HOLOGRAPHICpizza/logic-clock/schematic/logic-clock-layout.jpg

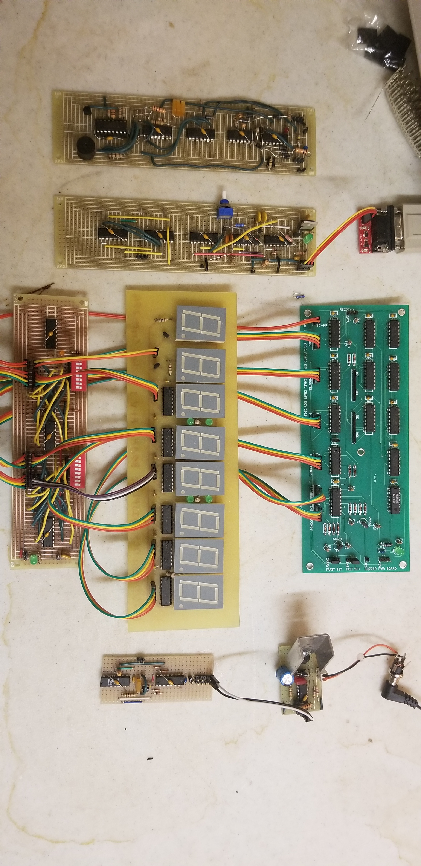
schematic/logic-clock-layout.jpg
