HOLOGRAPHICpizza/logic-clock/README.txt

Digital "synchronous" clock in 4000 series logic w/ incremental volume alarm and optional time set via RS-232.

By Michael Craft.

Released under the 2-Clause BSD License.
