HOLOGRAPHICpizza/logic-clock/schematic/logic-clock.pdf

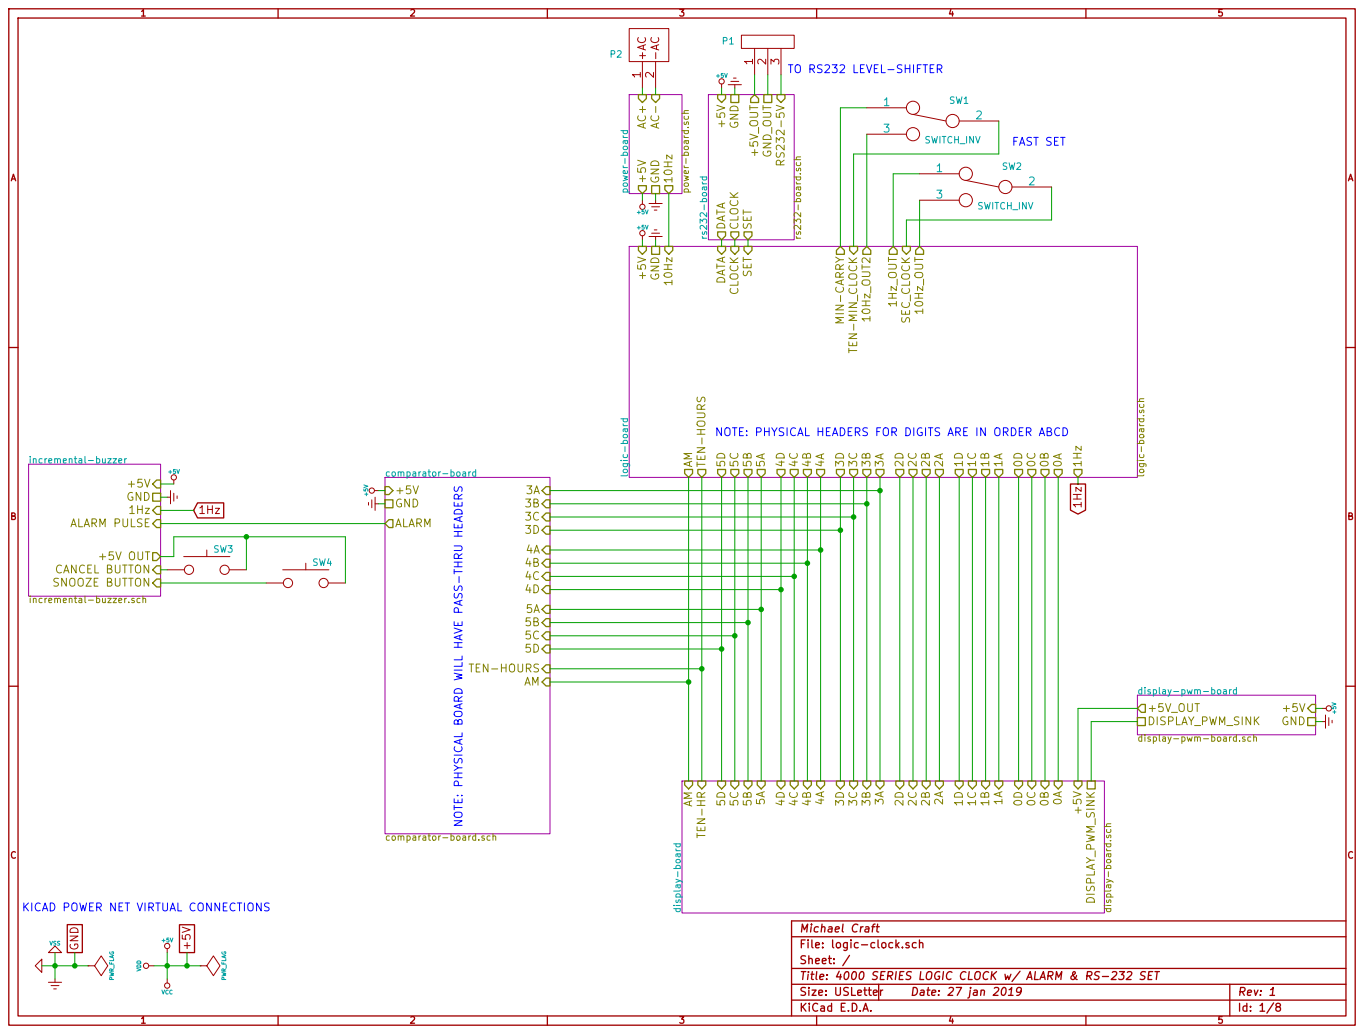
[picture p2: page 1]

comparator-board
comparator-board.sch +5V GND

incremental-buzzer.sch +5V GND

DISPLAY_PWM_SINK
display-pwm-board.sch

KICAD POWER NET VIRTUAL CONNECTIONS

Michael Craft
File: logic-clock.sch
Sheet: /
Title: 4000 SERIES LOGIC CLOCK w/ ALARM & RS-232 SET
KiCad E.D.A.

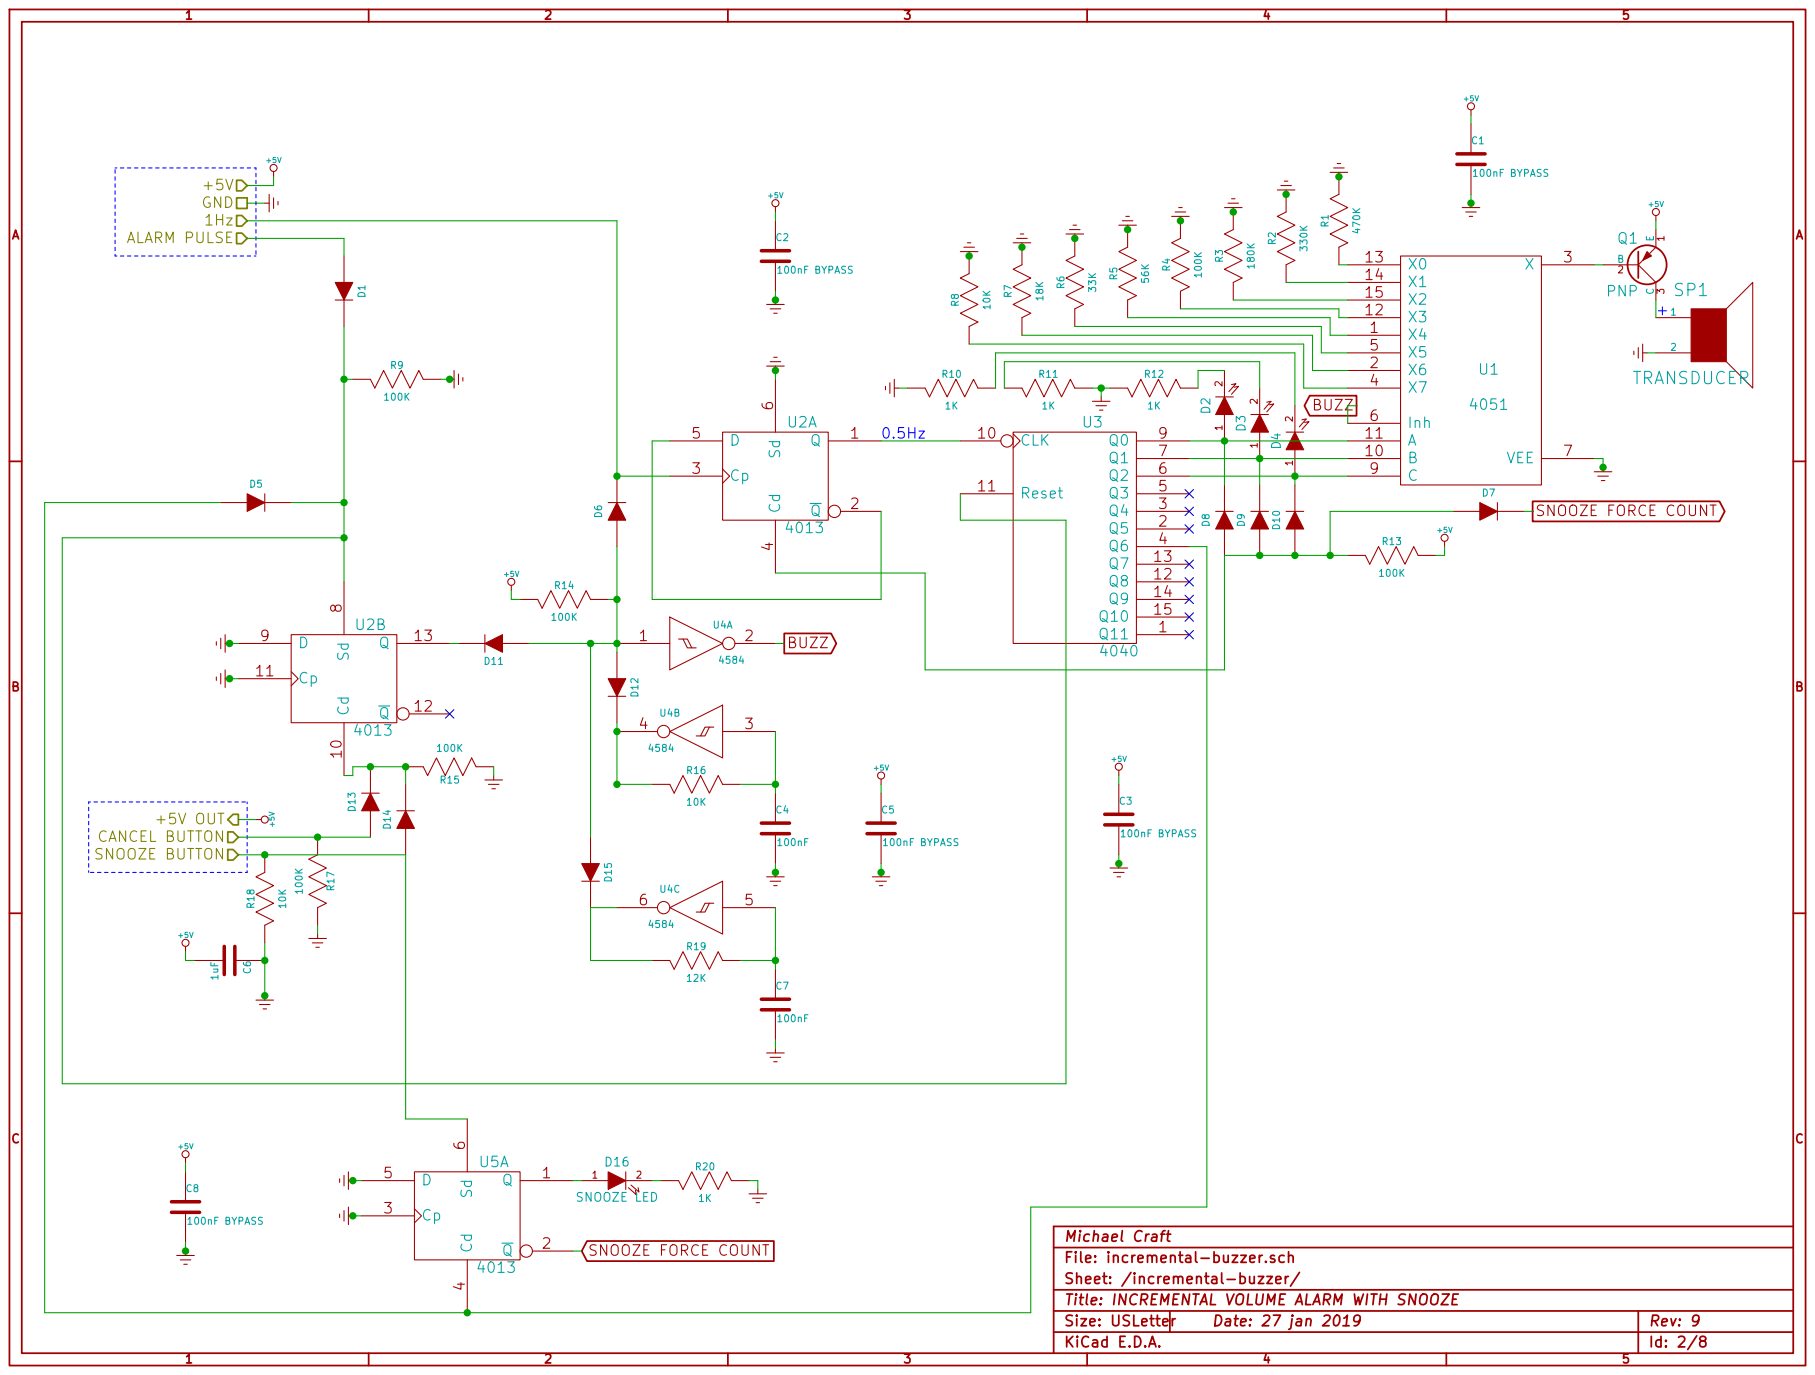
[picture p3: page 2]

Michael Craft
File: incremental-buzzer.sch Sheet: /incremental-buzzer/

Title: INCREMENTAL VOLUME ALARM WITH SNOOZE

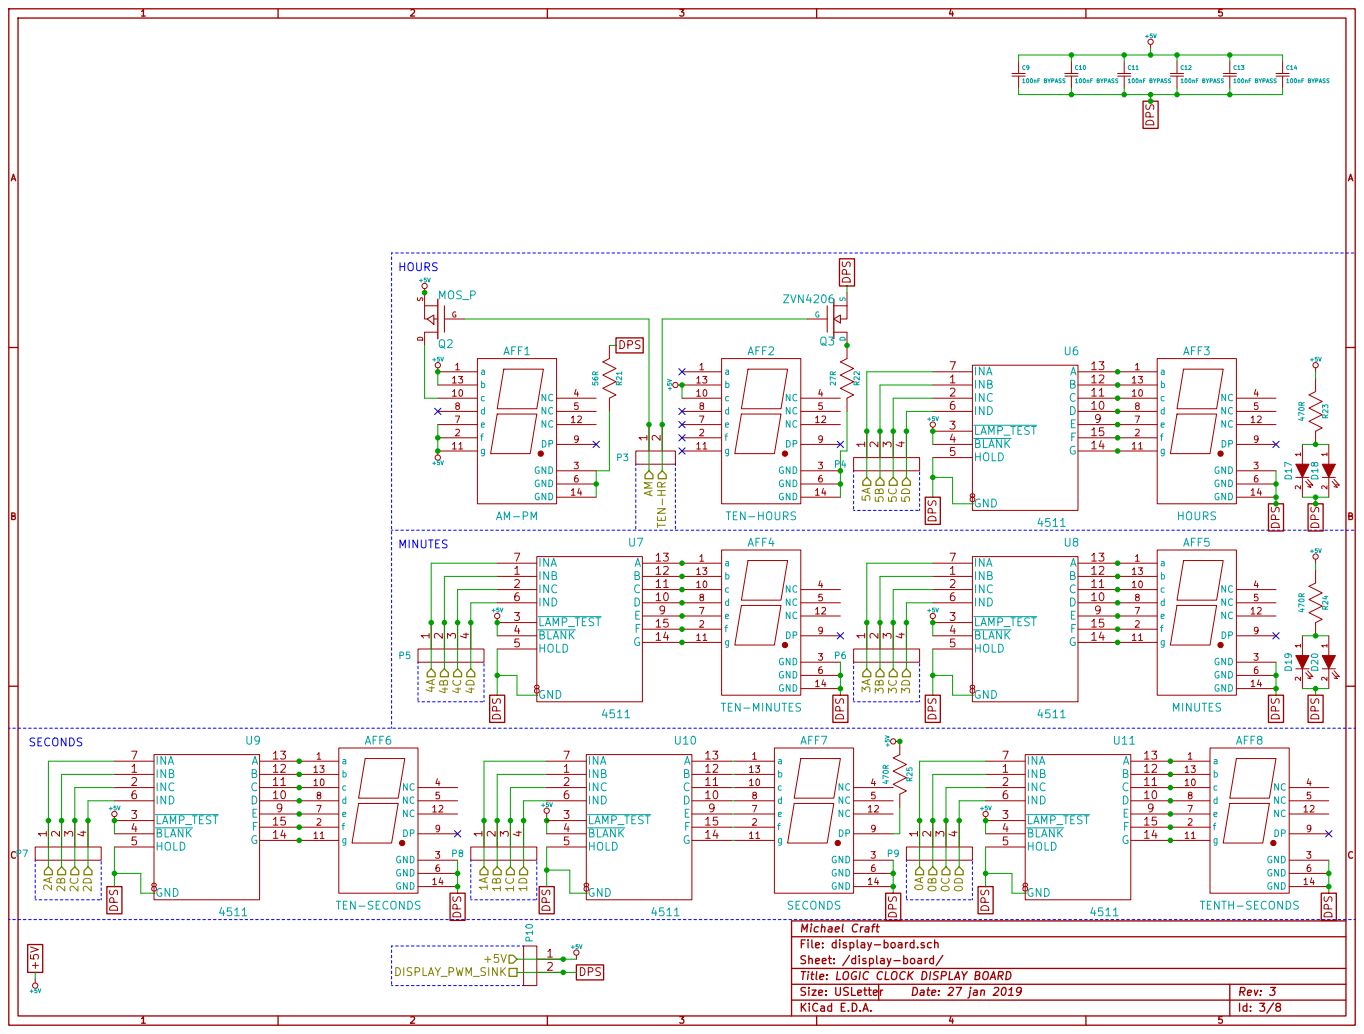
[picture p4: page 3]

Michael Craft
File: display-board.sch
Sheet: /display-board/
Title: LOGIC CLOCK DISPLAY BOARD

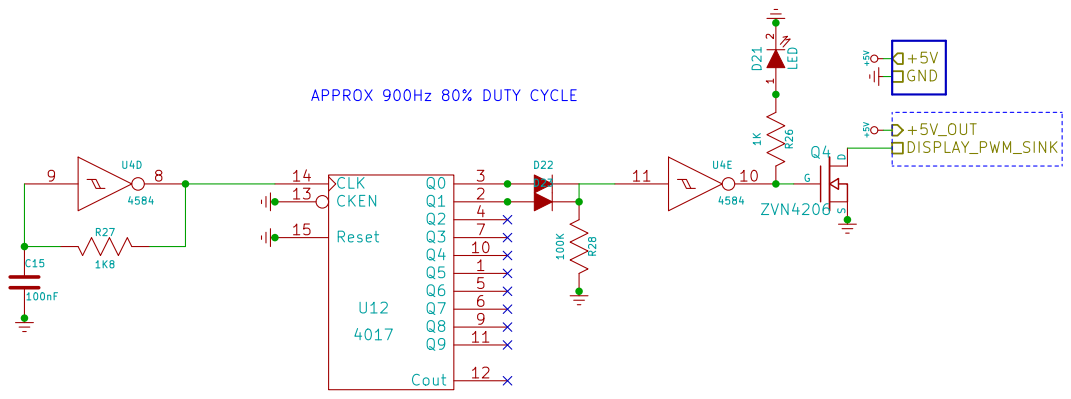
[picture p5: page 4]

Michael Craft
File: display-pwm-board.sch
Sheet: /display-pwm-board/
Title: LOGIC CLOCK DISPLAY PWM SIGNAL GENERATOR

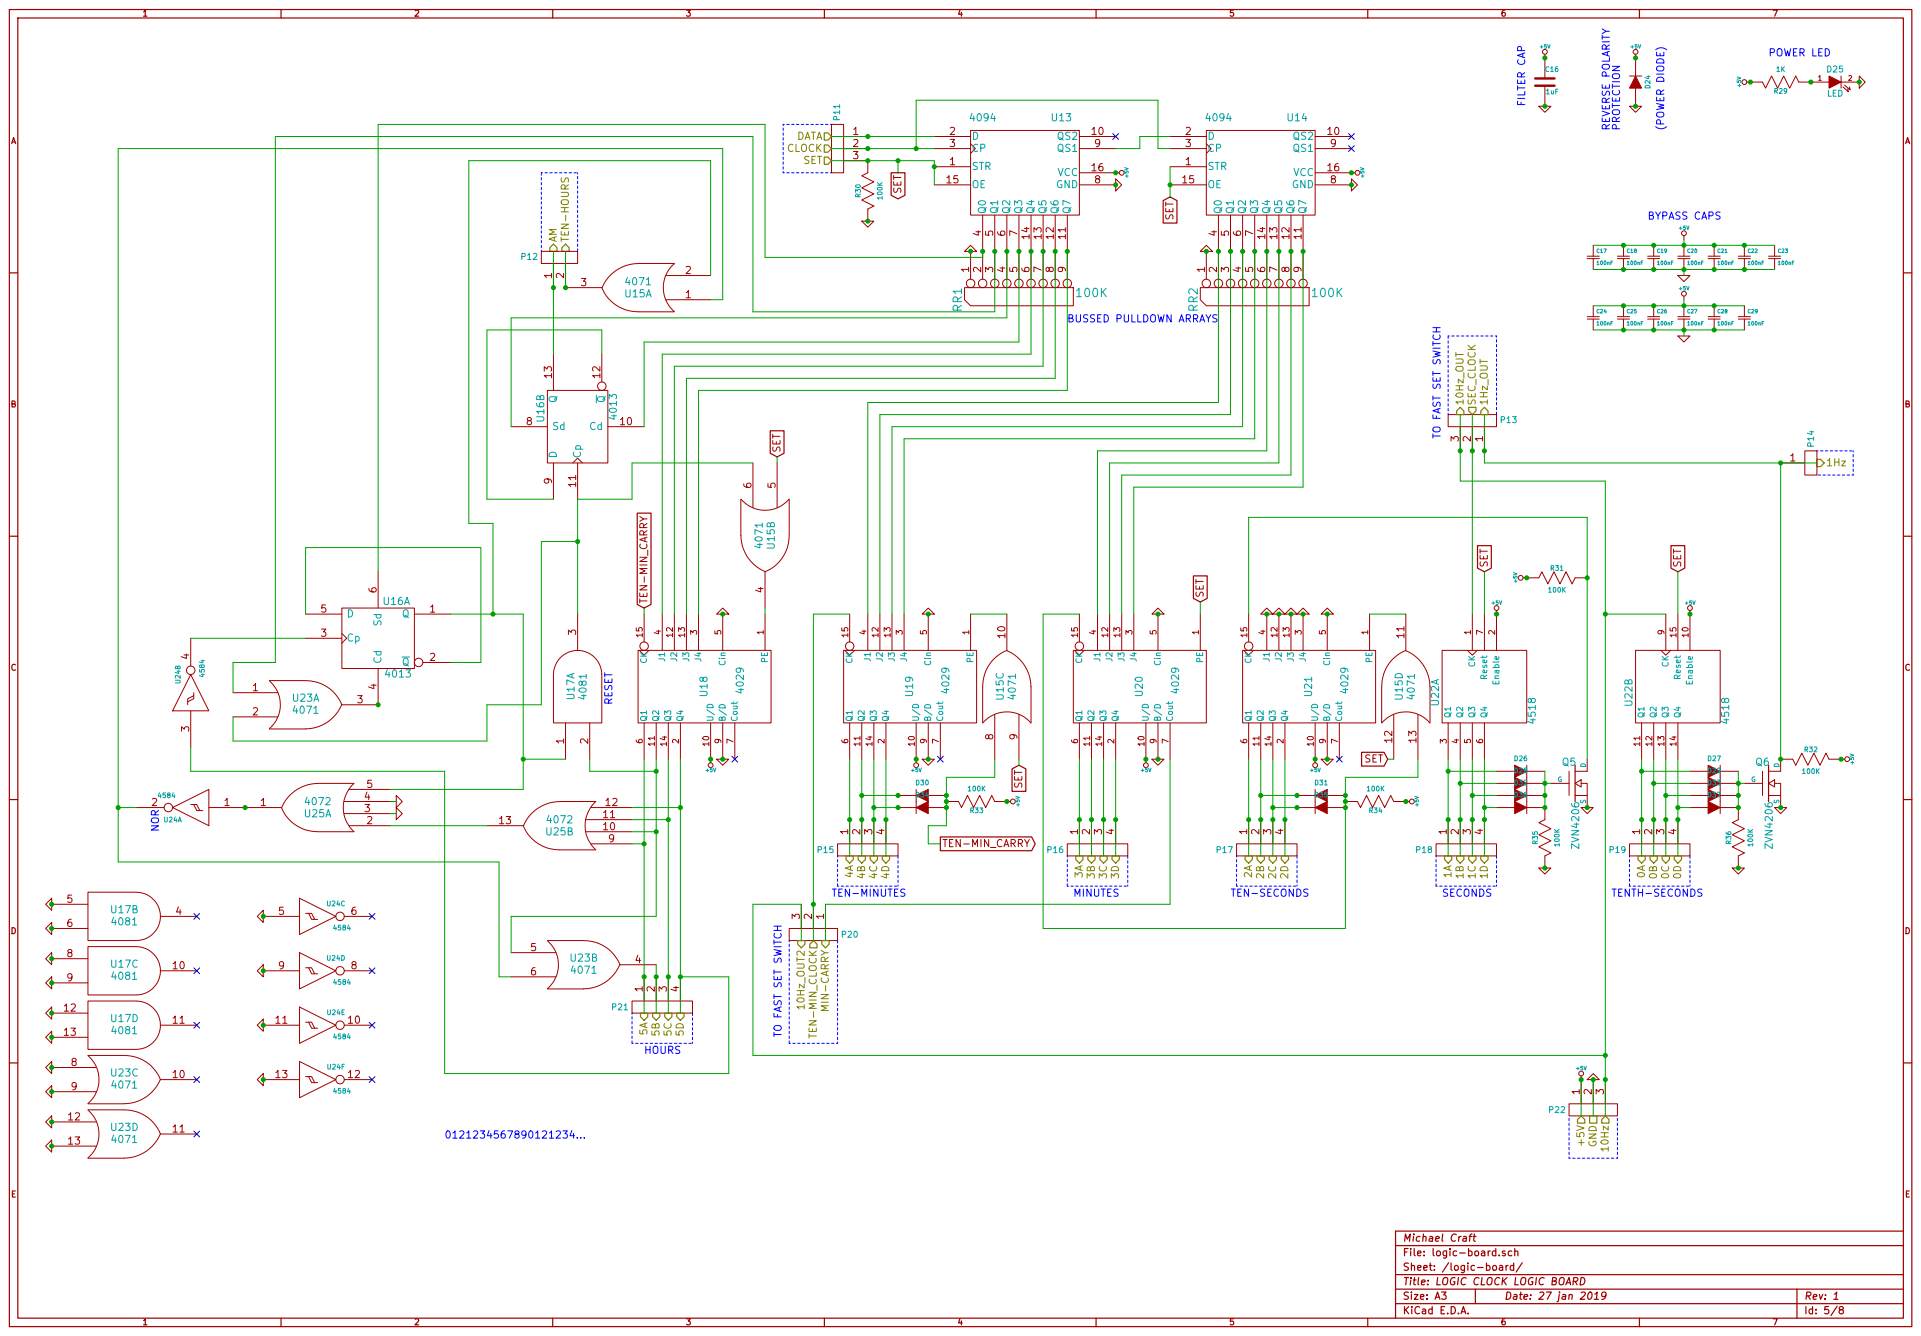
[picture p6: page 5]

9 Cd 10 Cp 11 Q 12 Q 13 U16B 4013 AMTEN-HOURS

P13 10Hz_OUT SEC_CLOCK 1Hz_OUT TO FAST SET SWITCH

File: logic-board.sch
Sheet: /logic-board/
Title: LOGIC CLOCK LOGIC BOARD

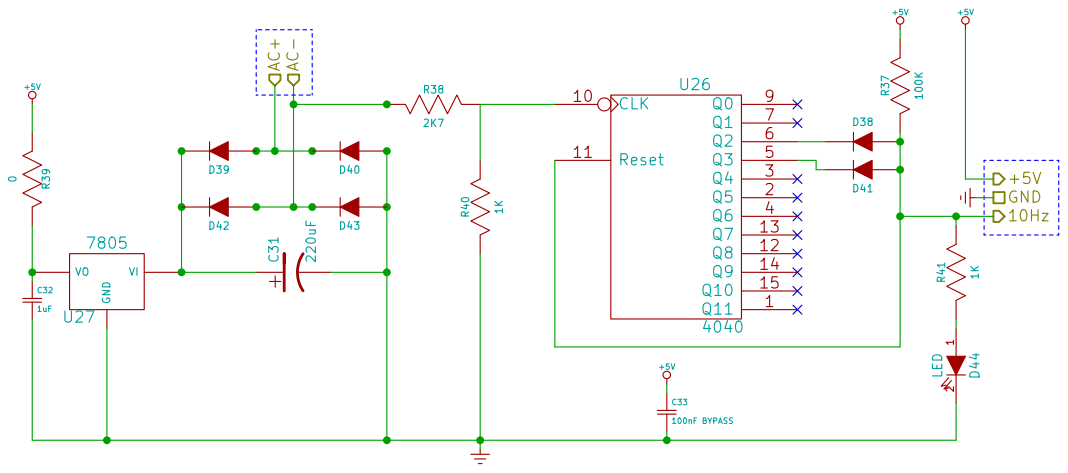
[picture p7: page 6]

File: power-board.sch

Title: 60Hz LOW VOLTAGE AC TO DC SUPPLY W/ 10Hz OUT

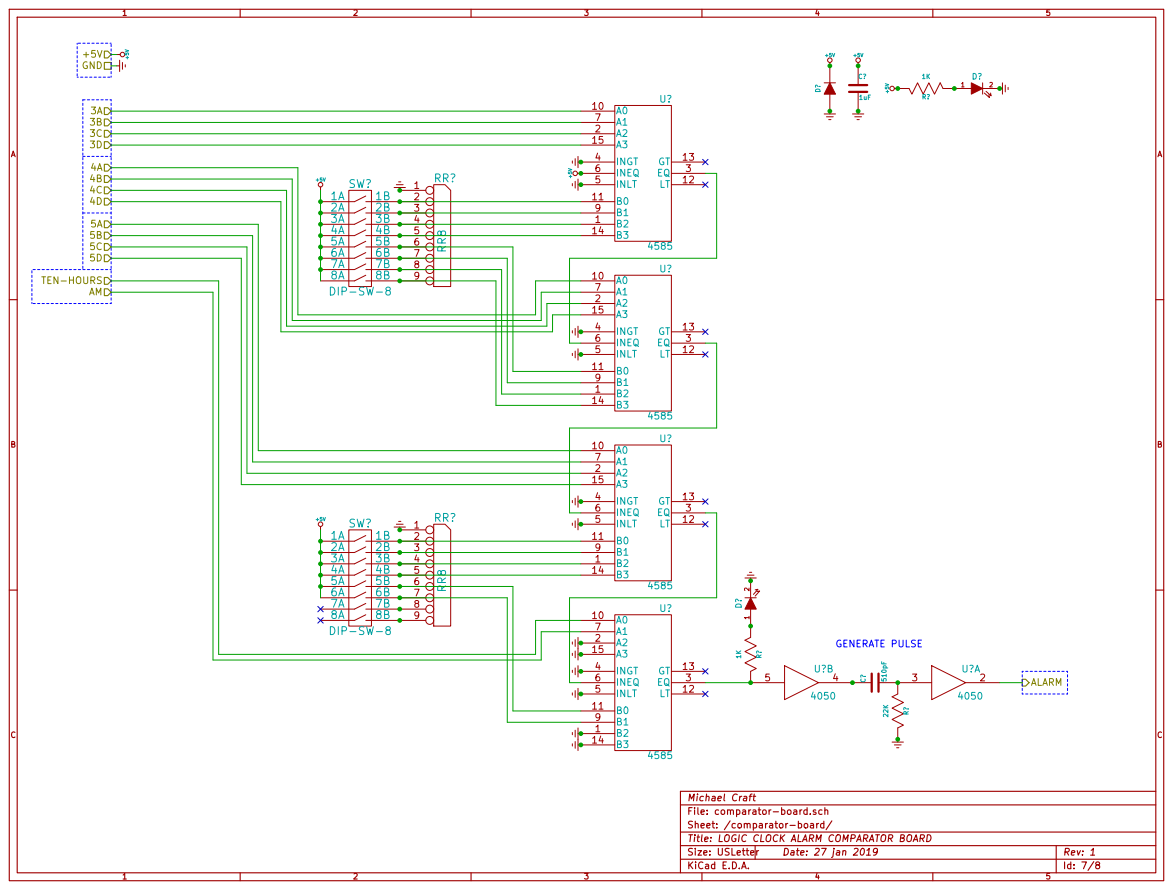
[picture p8: page 7]

Michael Craft
File: comparator-board.sch
Sheet: /comparator-board/
Title: LOGIC CLOCK ALARM COMPARATOR BOARD

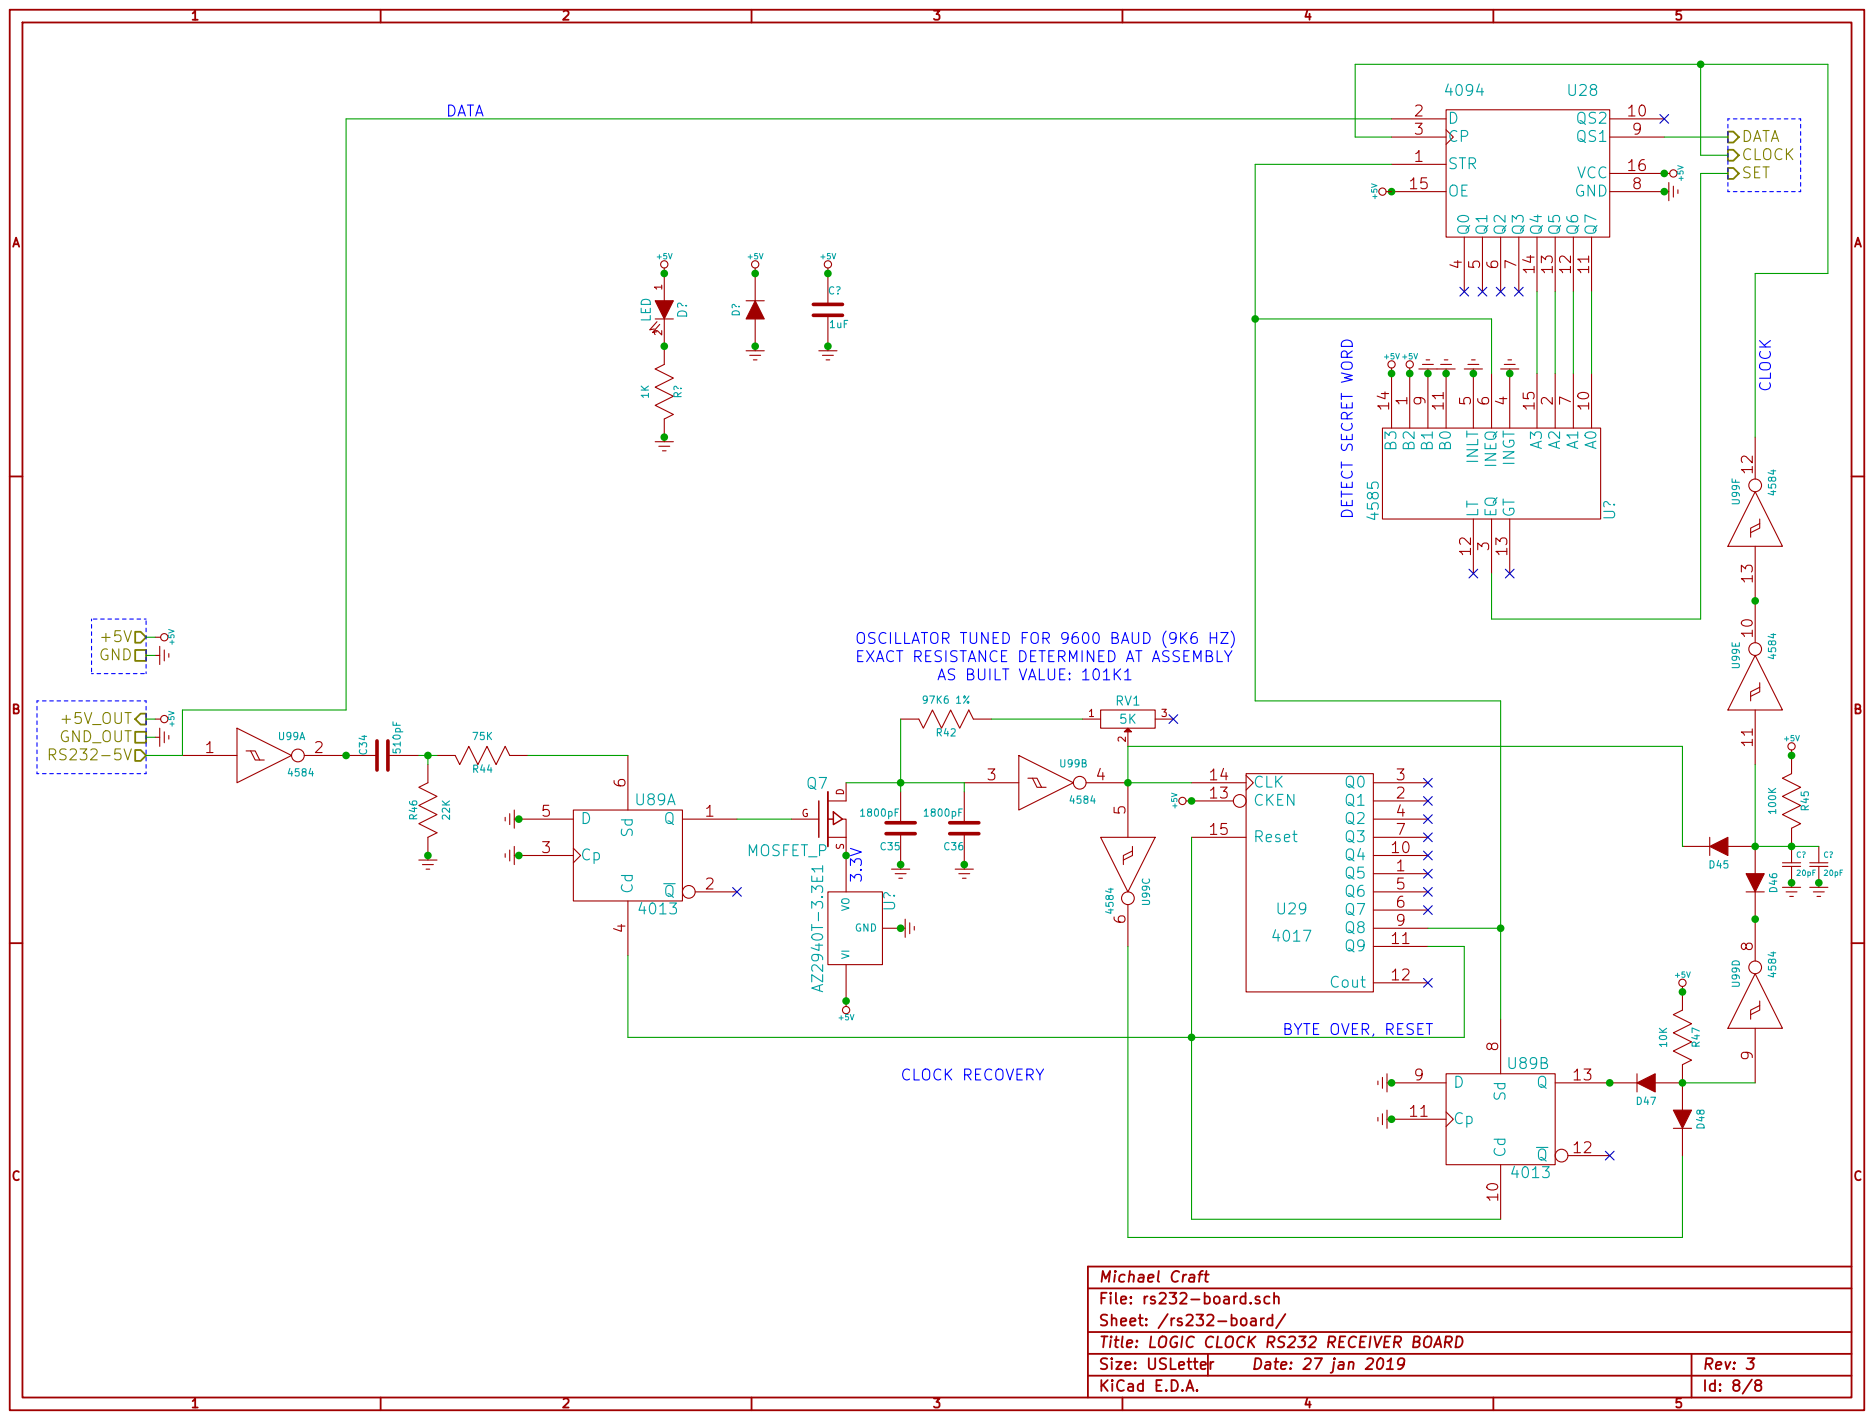
[picture p9: page 8]

1uF EXACT RESISTANCE DETERMINED AT ASSEMBLY

OSCILLATOR TUNED FOR 9600 BAUD (9K6 HZ)

Michael Craft
File: rs232-board.sch Sheet: /rs232-board/

Title: LOGIC CLOCK RS232 RECEIVER BOARD
