HOLOGRAPHICpizza/logic-clock/schematic/display-board_Cu.pdf

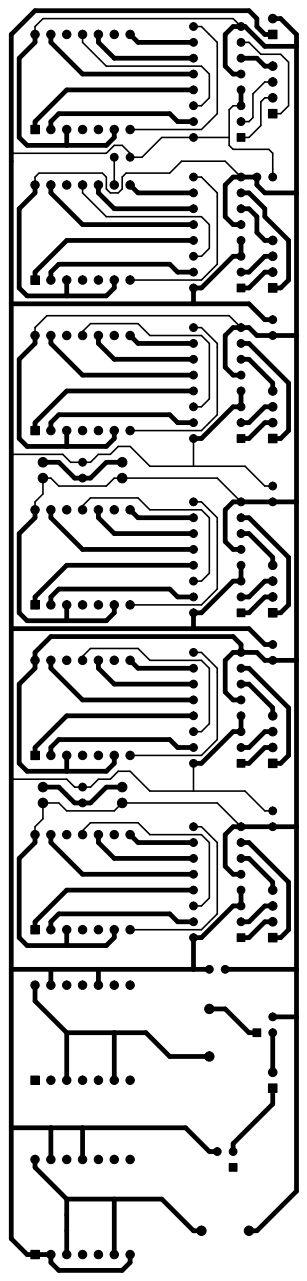
[picture p10: page 1]
