HOLOGRAPHICpizza/logic-clock/(list of files, drawings)

Other design files:
schematic/logic-clock.dsn
