HOLOGRAPHICpizza/logic-clock/schematic/logic-clock.kicad_pcb

## KiCad design schematic/logic-clock.kicad_pcb (2018-11-24)

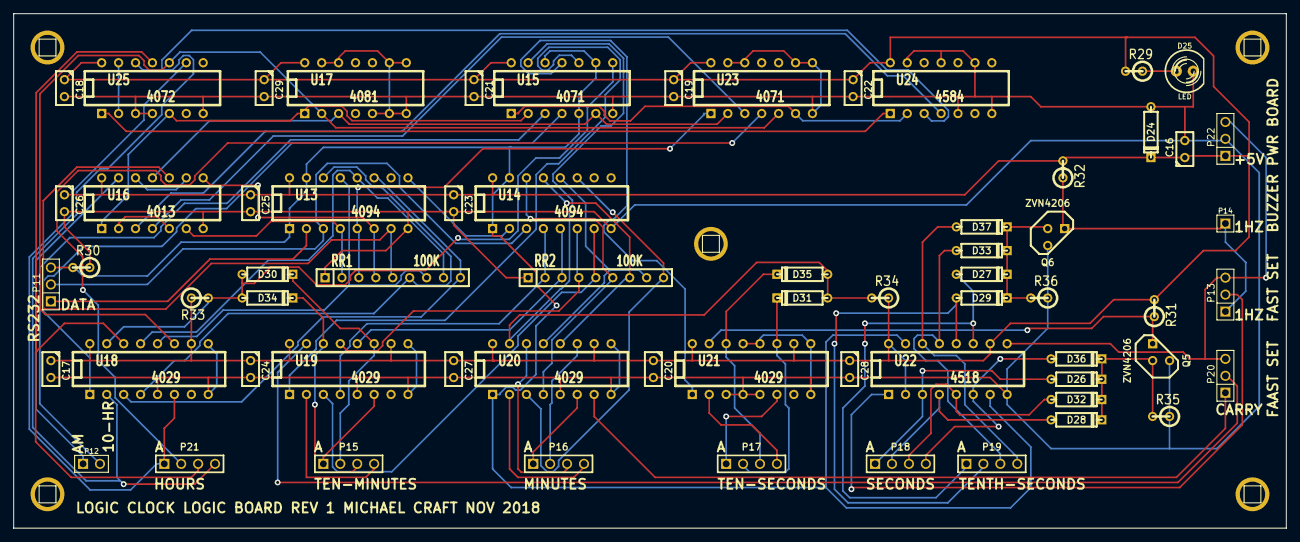
[picture p11: board logic-clock.kicad_pcb from above]

Board: 2 copper layers, 191.0 x 77.2 mm, 65 parts (0 on the bottom side), 72 nets.

Parts:
C16: 1uF; C1
C17, C18, C19, C20, C21, C22, C23, C24, C25, C26, C27, C28, C29: 100nF; C1
D24, D26, D27, D28, D29, D30, D31, D32, D33, D34, D35, D36, D37: DIODE; D3
D25: LED; LED-5MM
P11, P13, P20, P22: 3-PIN_HEADER; PIN_ARRAY_3X1
P12: 2-PIN_HEADER; PIN_ARRAY_2X1
P14: 1-PIN_HEADER; PIN_ARRAY_1
P15, P16, P17, P18, P19, P21: 4-PIN_HEADER; PIN_ARRAY_4x1
Q5, Q6: ZVN4206; TO92DGS
R29: 1K; R1
R30, R31, R32, R33, R34, R35, R36: 100K; R1
RR1, RR2: 100K; SIL-9
U13, U14: 4094; DIP-16__300
U15, U23: 4071; DIP-14__300
U16: 4013; DIP-14__300
U17: 4081; DIP-14__300
U18, U19, U20, U21: 4029; DIP-16__300
U22: 4518; DIP-16__300
U24: 4584; DIP-14__300
U25: 4072; DIP-14__300

Connections:
1Hz: P13.1, P14.1, Q6.D, R32.1
+5V: C16.1, C17.1, C18.1, C19.1, C20.1, C21.1, C22.1, C23.1, C24.1, C25.1, C26.1, C27.1, C28.1, C29.1, D24.2, P22.1, R29.2, R31.2, R32.2, R33.1, R34.1, U13.16, U14.16, U15.14, U16.14, U17.14, U18.10, U18.16, U19.10, U19.16, U20.10, U20.16, U21.10, U21.16, U22.2, U22.10, U22.16, U23.14, U24.14, U25.14
/comparator-board/3A: P16.1, U20.6
/comparator-board/3B: P16.2, U20.11
/comparator-board/3C: P16.3, U20.14
/comparator-board/3D: P16.4, U20.2
/comparator-board/4A: P15.1, U19.6
/comparator-board/4B: D30.2, P15.2, U19.11
/comparator-board/4C: D34.2, P15.3, U19.14
/comparator-board/4D: P15.4, U19.2
/comparator-board/5A: P21.1, U18.6, U25.9
/comparator-board/5B: P21.2, U23.4
/comparator-board/5C: P21.3, U18.14, U25.11
/comparator-board/5D: P21.4, U18.2, U24.3, U25.12
/comparator-board/AM: P12.1, U16.13
/comparator-board/TEN-HOURS: P12.2, U15.3
/display-board/0A: D27.1, P19.1, U22.11
/display-board/0B: D29.1, P19.2, U22.12
/display-board/0C: D33.1, P19.3, U22.13
/display-board/0D: D37.1, P19.4, U22.14
/display-board/1A: D26.1, P18.1, U22.3
/display-board/1B: D28.1, P18.2, U22.4
/display-board/1C: D32.1, P18.3, U22.5
/display-board/1D: D36.1, P18.4, U22.6
/display-board/2A: P17.1, U21.6
/display-board/2B: D31.2, P17.2, U21.11
/display-board/2C: D35.2, P17.3, U21.14
/display-board/2D: P17.4, U21.2
/logic-board/10Hz: P13.3, P20.3, P22.3, U22.9
/logic-board/CLOCK: P11.2, U13.3, U14.3
/logic-board/DATA: P11.1, U13.2
/logic-board/MIN-CARRY: P20.1, U20.7
/logic-board/SEC_CLOCK: P13.2, U22.1
/logic-board/TEN-MIN_CLOCK: P20.2, U19.15
GND: C16.2, C17.2, C18.2, C19.2, C20.2, C21.2, C22.2, C23.2, C24.2, C25.2, C26.2, C27.2, C28.2, C29.2, D24.1, D25.2, P22.2, Q5.S, Q6.S, R30.1, R35.1, R36.1, RR1.1, RR2.1, U13.8, U14.8, U15.7, U16.7, U17.5, U17.6, U17.7, U17.8, U17.9, U17.12, U17.13, U18.5, U18.8, U18.9, U19.5, U19.8, U19.9, U20.5, U20.8, U20.9, U21.3, U21.4, U21.5, U21.8, U21.9, U21.12, U21.13, U22.8, U23.7, U23.8, U23.9, U23.12, U23.13, U24.5, U24.7, U24.9, U24.11, U24.13, U25.3, U25.4, U25.7
unnamed: RR1.6, U13.14, U18.4
unnamed: RR1.5, U13.7, U16.10
unnamed: RR1.4, U13.6, U16.8
unnamed: RR2.9, U14.11, U20.3
unnamed: RR2.8, U14.12, U20.13
unnamed: RR2.7, U14.13, U20.12
unnamed: RR2.6, U14.14, U20.4
unnamed: RR2.5, U14.7, U19.3
unnamed: RR2.4, U14.6, U19.13
unnamed: RR2.3, U14.5, U19.12
unnamed: RR1.7, U13.13, U18.12
unnamed: RR1.8, U13.12, U18.13
unnamed: RR1.9, U13.11, U18.3
unnamed: U15.11, U21.1
unnamed: U15.10, U19.1
unnamed: RR1.2, U13.4, U16.6
unnamed: RR2.2, U14.4, U19.4
unnamed: U24.1, U25.1
unnamed: U25.2, U25.13
unnamed: U15.1, U23.6, U24.2
unnamed: U15.4, U18.1
unnamed: U16.9, U16.12
unnamed: U13.9, U14.2
unnamed: U16.2, U16.5
unnamed: RR1.3, U13.5, U23.1
unnamed: U15.6, U16.11, U17.3, U23.2
unnamed: U17.2, U18.11, U23.5, U25.10
unnamed: U16.3, U24.4
unnamed: U15.2, U16.1, U17.1, U25.5
unnamed: U16.4, U23.3
unnamed: D31.1, D35.1, R34.2, U15.13, U20.15
unnamed: D27.2, D29.2, D33.2, D37.2, Q6.G, R36.2
unnamed: D26.2, D28.2, D32.2, D36.2, Q5.G, R35.2
unnamed: Q5.D, R31.1, U21.15
unnamed: D25.1, R29.1
SET: P11.3, R30.2, U13.1, U13.15, U14.1, U14.15, U15.5, U15.9, U15.12, U20.1, U22.7, U22.15
TEN-MIN_CARRY: D30.1, D34.1, R33.2, U15.8, U18.15
