HOLOGRAPHICpizza/logic-clock/schematic/display-board.kicad_pcb

## KiCad design schematic/display-board.kicad_pcb (2016-06-25)

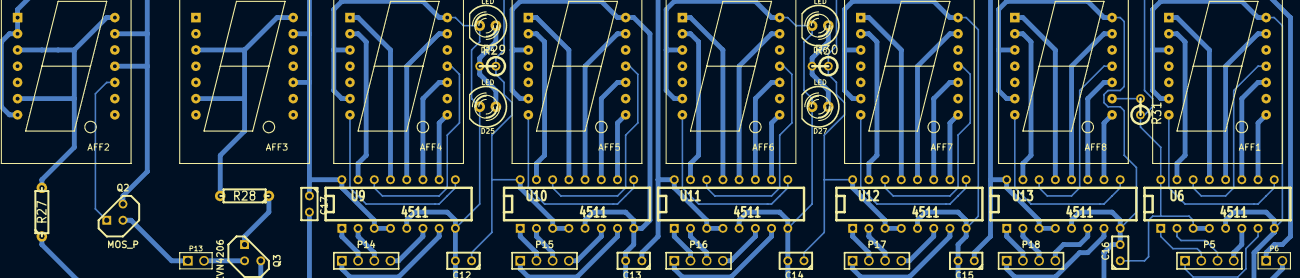
[picture p12: board display-board.kicad_pcb from above]

Board: 2 copper layers, 39 parts (0 on the bottom side), 77 nets.

Parts:
AFF1: TENTH-SECONDS; 7SEG-KB
AFF2: AM-PM; 7SEG-KB
AFF3: TEN-HOURS; 7SEG-KB
AFF4: HOURS; 7SEG-KB
AFF5: TEN-MINUTES; 7SEG-KB
AFF6: MINUTES; 7SEG-KB
AFF7: TEN-SECONDS; 7SEG-KB
AFF8: SECONDS; 7SEG-KB
C12, C13, C14, C15, C16, C17: 100nF BYPASS; C1
D24, D25, D26, D27: LED; LED-5MM
P5, P14, P15, P16, P17, P18: 4-PIN_HEADER; PIN_ARRAY_4x1
P6, P13: 2-PIN_HEADER; PIN_ARRAY_2X1
Q2: MOS_P; TO92DGS
Q3: ZVN4206; TO92DGS
R27, R28: 1K; R3-LARGE_PADS
R29, R30, R31: 1K; R1
U6, U9, U10, U11, U12, U13: 4511; DIP-16__300

Connections:
+5V: AFF2.1, AFF2.2, AFF2.7, AFF2.11, AFF2.13, AFF3.10, AFF3.13, C12.1, C13.1, C14.1, C15.1, C16.1, C17.1, P6.1, Q2.S, R29.1, R30.1, R31.1, U6.3, U6.4, U6.16, U9.3, U9.4, U9.16, U10.3, U10.4, U10.16, U11.3, U11.4, U11.16, U12.3, U12.4, U12.16, U13.3, U13.4, U13.16
/display-board/0A: P5.1, U6.7
/display-board/0B: P5.2, U6.1
/display-board/0C: P5.3, U6.2
/display-board/0D: P5.4, U6.6
/display-board/1A: P18.1, U13.7
/display-board/1B: P18.2, U13.1
/display-board/1C: P18.3, U13.2
/display-board/1D: P18.4, U13.6
/display-board/2A: P17.1, U12.7
/display-board/2B: P17.2, U12.1
/display-board/2C: P17.3, U12.2
/display-board/2D: P17.4, U12.6
/display-board/3A: P16.1, U11.7
/display-board/3B: P16.2, U11.1
/display-board/3C: P16.3, U11.2
/display-board/3D: P16.4, U11.6
/display-board/4A: P15.1, U10.7
/display-board/4B: P15.2, U10.1
/display-board/4C: P15.3, U10.2
/display-board/4D: P15.4, U10.6
/display-board/5A: P14.1, U9.7
/display-board/5B: P14.2, U9.1
/display-board/5C: P14.3, U9.2
/display-board/5D: P14.4, U9.6
/display-board/AM: P13.1, Q2.G
/display-board/TEN-HR: P13.2, Q3.G
GND: AFF1.3, AFF1.6, AFF1.14, AFF4.3, AFF4.6, AFF4.14, AFF5.3, AFF5.6, AFF5.14, AFF6.3, AFF6.6, AFF6.14, AFF7.3, AFF7.6, AFF7.14, AFF8.3, AFF8.6, AFF8.14, C12.2, C13.2, C14.2, C15.2, C16.2, C17.2, D24.2, D25.2, D26.2, D27.2, P6.2, Q3.S, R27.1, U6.5, U6.8, U9.5, U9.8, U10.5, U10.8, U11.5, U11.8, U12.5, U12.8, U13.5, U13.8
unnamed: AFF4.7, U9.9
unnamed: AFF4.8, U9.10
unnamed: AFF4.10, U9.11
unnamed: AFF4.13, U9.12
unnamed: AFF4.1, U9.13
unnamed: AFF4.11, U9.14
unnamed: AFF4.2, U9.15
unnamed: D24.1, D25.1, R29.2
unnamed: AFF5.1, U10.13
unnamed: AFF5.11, U10.14
unnamed: AFF5.2, U10.15
unnamed: AFF5.13, U10.12
unnamed: AFF5.7, U10.9
unnamed: AFF5.8, U10.10
unnamed: AFF5.10, U10.11
unnamed: AFF2.10, Q2.D
unnamed: AFF8.7, U13.9
unnamed: AFF8.1, U13.13
unnamed: AFF8.13, U13.12
unnamed: AFF8.10, U13.11
unnamed: AFF8.8, U13.10
unnamed: AFF8.2, U13.15
unnamed: AFF8.11, U13.14
unnamed: Q3.D, R28.1
unnamed: AFF3.3, AFF3.6, AFF3.14, R28.2
unnamed: AFF2.3, AFF2.6, AFF2.14, R27.2
unnamed: AFF1.2, U6.15
unnamed: AFF1.1, U6.13
unnamed: AFF1.7, U6.9
unnamed: AFF1.8, U6.10
unnamed: AFF1.10, U6.11
unnamed: AFF1.11, U6.14
unnamed: AFF1.13, U6.12
unnamed: AFF6.7, U11.9
unnamed: AFF6.8, U11.10
unnamed: AFF6.10, U11.11
unnamed: AFF6.13, U11.12
unnamed: AFF6.1, U11.13
unnamed: AFF6.11, U11.14
unnamed: AFF6.2, U11.15
unnamed: AFF7.8, U12.10
unnamed: AFF7.7, U12.9
unnamed: AFF7.10, U12.11
unnamed: AFF7.13, U12.12
unnamed: AFF7.1, U12.13
unnamed: AFF7.11, U12.14
unnamed: AFF7.2, U12.15
unnamed: D26.1, D27.1, R30.2
unnamed: AFF8.9, R31.2
