HOLOGRAPHICpizza/logic-clock/(commit log)

2016-04-18 changed pull-down resistor
    [incremental-buzzer.sch]
2016-04-18 enhanced input protection
    [incremental-buzzer.sch]
2016-04-18 better volume ramp
    [incremental-buzzer.sch]
2016-05-30 cleanup kicad project
    [display-board.sch]
2016-05-30 cleaned up kicad project more
    [display-board.sch, incremental-buzzer.sch, logic-clock.kicad_pcb, logic-clock.sch, power-board.sch]
2016-05-30 started pcb
    [display-board.sch, incremental-buzzer.sch, logic-clock.kicad_pcb, logic-clock.sch, power-board.sch]
2016-05-30 display board schematic
    [display-board.sch, incremental-buzzer.sch, logic-clock.sch, power-board.sch]
2016-05-31 pcb rev 1
    [display-board.sch, logic-clock.kicad_pcb, logic-clock.sch, power-board.sch]
2016-05-31 pcb rev 2
    [logic-clock.kicad_pcb]
2016-05-31 pcb rev 3
    [logic-clock.kicad_pcb]
2016-06-25 lots of stuff
    [display-board.sch, incremental-buzzer.sch, logic-clock.X.production.obj, logic-clock.kicad_pcb, logic-clock.sch, power-board.sch]
2016-06-25 PWM improved
    [logic-clock.X.production.obj]
2016-06-28 PWM improved again lol
    [logic-clock.X.production.obj]
2016-06-29 transmits zeros to clear shift registers
    [logic-clock.X.production.obj]
2016-07-15 working on schematic...
    [display-board.sch, incremental-buzzer.sch, logic-board.sch, logic-clock.sch, power-board.sch]
2016-07-15 one more digit
    [logic-board.sch]
2016-08-15 schematic matches prototype
    [display-board.sch, incremental-buzzer.sch, logic-board.sch, logic-clock.sch, power-board.sch]
2016-08-15 ok now it is correct mostly
    [logic-board.sch]
2016-08-15 added shift registers
    [logic-board.sch]
2016-08-15 ok i think this should be hooked up right
    [logic-board.sch]
2016-08-15 resized page
    [logic-board.sch]
2016-08-23 1st digit bug fix, disabled TX zeros
    [display-board.sch, incremental-buzzer.sch, logic-board.sch, logic-clock.sch, power-board.sch]
2016-08-23 2nd digit bug fix
    [logic-board.sch]
2016-08-23 reset bug fix
    [logic-board.sch]
2016-08-25 added display pwm board
    [display-board.sch, display-pwm-board.sch, incremental-buzzer.sch, logic-board.sch, logic-clock.sch, power-board.sch]
2016-08-28 schematic is "done"
    [comparator-board.sch, display-board.sch, display-pwm-board.sch, incremental-buzzer.sch, logic-board.sch, logic-clock.sch, power-board.sch, rs232-board.sch]
2016-08-28 added fast set
    [incremental-buzzer.sch, logic-board.sch, logic-clock.sch]
2016-08-28 added note
    [logic-board.sch]
2016-08-29 started rs232 board
    [comparator-board.sch, display-board.sch, display-pwm-board.sch, incremental-buzzer.sch, logic-board.sch, logic-clock.sch, power-board.sch, rs232-board.sch]
2016-11-08 I HAVE NO IDEA
    [comparator-board.sch, display-board.sch, display-pwm-board.sch, incremental-buzzer.sch, logic-board.sch, logic-clock.sch, power-board.sch, rs232-board.sch]
2016-11-20 minutes and seconds digits confirmed working, hours needs work
    [comparator-board.sch, display-board.sch, display-pwm-board.sch, incremental-buzzer.sch, logic-board.sch, logic-clock.sch, power-board.sch, rs232-board.sch]
2016-11-20 added some resistors, works better
    [logic-board.sch]
2018-10-29 replaced some diode gates with CMOS gates
    [comparator-board.sch, display-board.sch, display-pwm-board.sch, incremental-buzzer.sch, logic-board.sch, logic-clock.sch, power-board.sch, rs232-board.sch]
2018-11-08 idk what changed i hope nothing is broken
    [comparator-board.sch, display-board.sch, display-pwm-board.sch, incremental-buzzer.sch, logic-board.sch, logic-clock.sch, power-board.sch, rs232-board.sch]
2018-11-19 prototype works!
    [comparator-board.sch, display-board.sch, display-pwm-board.sch, incremental-buzzer.sch, logic-board.sch, logic-clock.sch, power-board.sch, rs232-board.sch]
2018-11-19 passes ERC
    [comparator-board.sch, display-board.sch, display-pwm-board.sch, incremental-buzzer.sch, logic-board.sch, logic-clock.sch, power-board.sch, rs232-board.sch]
2018-11-20 ready to lay out pcb
    [display-board.kicad_pcb, logic-clock.kicad_pcb]
2018-11-23 layout almost ready for routing
    [comparator-board.sch, display-board.sch, display-pwm-board.sch, incremental-buzzer.sch, logic-board.sch, logic-clock.kicad_pcb, logic-clock.sch, power-board.sch]
2018-11-23 minor schematic edit and new netlist
    [comparator-board.sch, logic-board.sch, power-board.sch, rs232-board.sch]
2018-11-23 fixed unused chip connections
    [comparator-board.sch, logic-board.sch, logic-clock.kicad_pcb, power-board.sch, rs232-board.sch]
2018-11-24 half laid out, fixed netlist again
    [comparator-board.sch, display-board.sch, display-pwm-board.sch, incremental-buzzer.sch, logic-board.sch, logic-clock.kicad_pcb, logic-clock.sch, power-board.sch]
2018-11-24 about to try some sort of autorouter
    [logic-clock.kicad_pcb]
2018-11-24 ready for autorouter
    [logic-clock.dsn, logic-clock.kicad_pcb]
2018-11-24 actually ready for autoroute
    [logic-clock.dsn, logic-clock.kicad_pcb]
2018-11-24 autoroute complete
    [logic-clock.dsn, logic-clock.kicad_pcb]
2018-11-24 added drill holes, should be ready for manufacture
    [logic-clock.kicad_pcb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]
2018-11-27 working on RS232 receiver
    [comparator-board.sch, display-board.sch, display-pwm-board.sch, incremental-buzzer.sch, logic-board.sch, logic-clock.sch, power-board.sch, rs232-board.sch]
2018-11-27 still working on rs232
    [rs232-board.sch]
2018-11-28 RS232 should be done now, still untested
    [comparator-board.sch, display-board.sch, display-pwm-board.sch, incremental-buzzer.sch, logic-board.sch, logic-clock.sch, power-board.sch, rs232-board.sch]
2018-11-28 added rs232 output buffer
    [rs232-board.sch]
2018-11-28 simplified RS232, bench test successful, needs tested against actual logic board
    [rs232-board.sch]
2018-12-09 set-logic-clock updated to use rs232 circuit and take arguments
2019-01-12 RS232 board REV 3
    [comparator-board.sch, display-board.sch, display-pwm-board.sch, incremental-buzzer.sch, logic-board.sch, logic-clock.sch, power-board.sch, rs232-board.sch]
2019-01-13 started comparator board
    [comparator-board.sch, display-board.sch, display-pwm-board.sch, incremental-buzzer.sch, logic-board.sch, logic-clock.sch, power-board.sch, rs232-board.sch]
2019-01-27 "v1.0" Schematics are "finished". Final assembly is not yet complete and changes may be required. Everything has been tested, at least by itself.
    [comparator-board.sch, display-board.sch, display-pwm-board.sch, incremental-buzzer.sch, logic-board.sch, logic-clock.sch, power-board.sch, rs232-board.sch]
